TomOndiba/FFM/README.md

# GIY
## _Facking fire machine by GIY team_



# _Facking fire machine is a dangerous assassinator made by GIY team for group dynamics classes. This craft is driven by (madness) android smartphone application, which requires bluetooth connection. It provides remote driving and firing controll. It can be used by the USA army or elsewhere to murder people, smoke cigarettes, cook or just have fun with friends. It has a rechargable accumulator and refillable fire dispenser._
# _Ahtung! No children or pregnant subjects are allowed to be located 200 meters around FFM._ 

### Team Members
 
 * Олексій Атаманюк - Project Owner
 * Віталій Кривенко - Scrum Master
 * Даниїл  Песчанський - TeamLead
 * Віталій Качанов - Lead QA
 * Анатолій Санжаровський - Programmer
 * Володимир Мікулін - QA Engineer

# Artifacts
[Team_presentation](https://docs.google.com/presentation/d/1QD8TVtB5wpbqer4k4fWklAO9wPiQcV2aGm7y0YjSvZY/edit?usp=sharing)\
[Product baclog](https://docs.google.com/spreadsheets/d/1HHw5KDrVk0AnSIGJreH4jOdfpb7VtTAZhVpm-1HU2tU/edit#gid=0)

## First sprint

1. [Meeting results](https://docs.google.com/document/d/1aGb1IYfKZ627R_a4WIMSae-ZWUQ8NoL-mD4qlwgQoQ4/edit)
2. [Burndown chart](https://docs.google.com/spreadsheets/d/1AHfeBAYtMuiKIl9go-UKPJXa0bIa4qfdzB3qVkTlnWc/edit?usp=sharing)
3. [Demonstration](https://docs.google.com/presentation/d/1P59UH1bn7VWtPSnJD2ycK9QTWsynzHFF-v7N4FJcUHY/edit?usp=sharing)
4. [Retrospective](https://docs.google.com/spreadsheets/d/1-wMHiNpxTyazeuUBJY6sjtFUaTjWSGKvCouLZwBrpuo/edit?usp=sharing)
## Second sprint
1. [Meeting results_2](https://docs.google.com/document/d/1xvqzVWKK_oI9fB8WkdZ0YjJwwyxLWVSJzXTbQxAW1tw/edit?usp=sharing)
2. [Burndown chart](https://docs.google.com/spreadsheets/d/1AHfeBAYtMuiKIl9go-UKPJXa0bIa4qfdzB3qVkTlnWc/edit#gid=1319640914)
3. [docs](https://docs.google.com/spreadsheets/d/1HHw5KDrVk0AnSIGJreH4jOdfpb7VtTAZhVpm-1HU2tU/edit#gid=0)
4. [DOCS manual](https://github.com/progbase/FFM/blob/master/DOCS.md)
## Video
[GIY top video](https://www.youtube.com/watch?v=ccJMni9_E28&feature=youtu.be)
